Aarav06635/UVC-LED-DRIVER/IISC project certificate .pdf

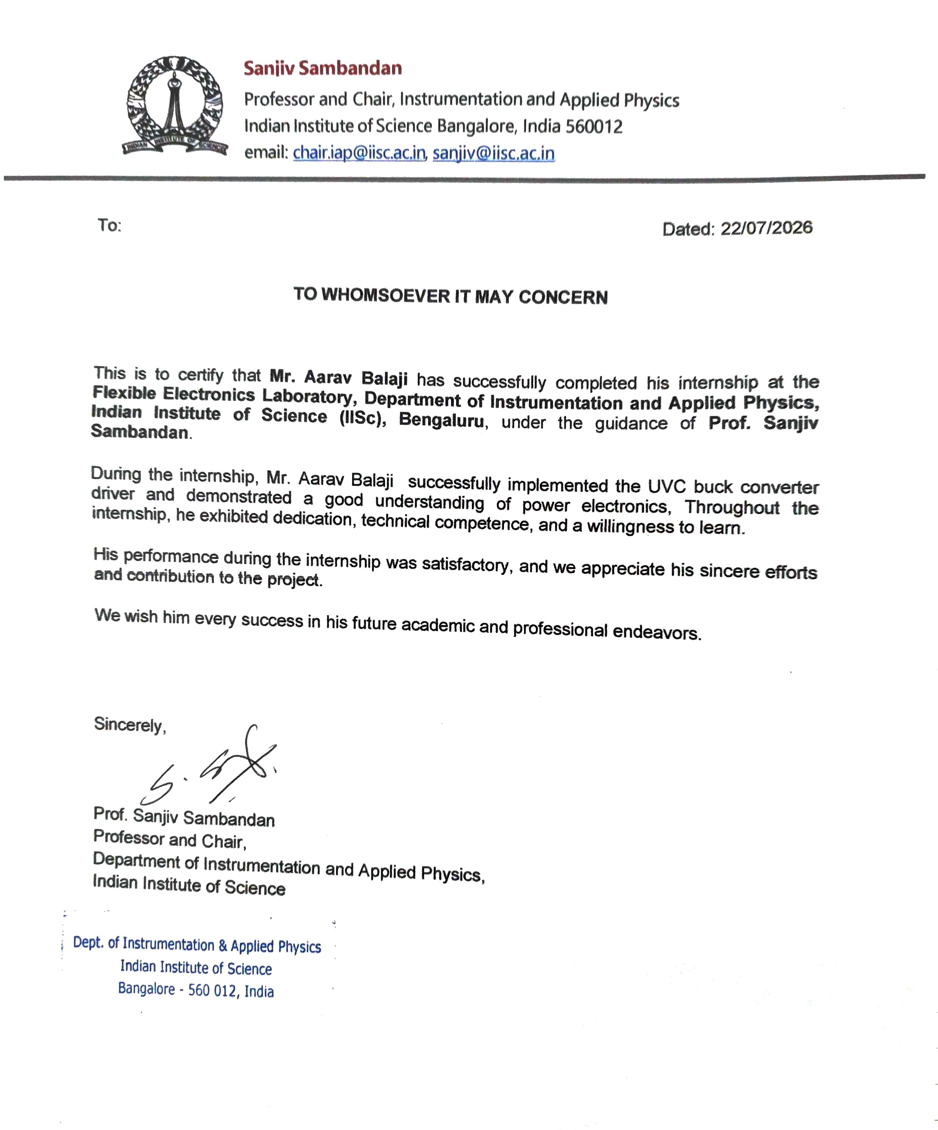
[picture p8: page 1]
