Aarav06635/UVC-LED-DRIVER/LED driver.asc

C1: cap; 1n
C2: cap; 1µ
D1: diode; 1N5818
L1: ind; 1m
M1: nmos; IRFZ44N
R1: res; 100
R2: res; 10k
R3: res; 30
V1: voltage; 18
V2: voltage; PULSE(0 25 0 10n 10n 13.3u 20u)
Named nets: 0
.tran 0 5m 0 100n
