Aarav06635/UVC-LED-DRIVER/LED driver_2.asc

C1: cap; 220n
C2: cap; 1µ
D1: diode; 1N5818
D2: diode; 1N4148
L1: ind; 1m
M1: nmos; IRFZ44N
M2: nmos; IRFZ44N
M3: nmos; IRFZ44N
R1: res; 100
R3: res; 30
V1: voltage; 18
V2: voltage; PULSE(0 25 0 10n 10n 6.7u 20u)
Named nets: 0
.tran 0 20m 0 100n
Bootstrap method
