Aarav06635/UVC-LED-DRIVER/LED driver_3.asc

C1: cap; 220n
C2: cap; 1µ
C3: cap; 30n
D1: diode; 1N5818
D2: diode; 1N4148
D3: diode; 1N4148
L1: ind; 1m
M1: nmos; IRFZ44N
M2: nmos; IRFZ44N
M3: nmos; IRFZ44N
R1: res; 100
R2: res; 12k
R3: res; 30
V1: voltage; 18
V2: voltage; PULSE(0 5 0 10n 10n 6.7u 20u)
Named nets: 0
.tran 0 20m 0 100n
Snubber included
