Aarav06635/UVC-LED-DRIVER/LED driver_5 PROTOTYPE .asc

C1: cap; 200n
C2: cap; 10µ
C3: cap; 300n
D1: diode; 1N5818
D2: diode; 1N4148
D3: diode; 1N4148
L1: ind; 1m
M1: nmos; IRFZ44N
M2: nmos; IRFZ44N
M3: nmos; IRFZ44N
R1: res; 100
R2: res; 1k
R3: res; 7
R4: res; 10K
V1: voltage; 18
V2: voltage; PULSE(0 5 0 10n 10n 11.1u 50u)
Named nets: 0
.tran 0 30m 0 100n
Klaaran
