Aarav06635/UVC-LED-DRIVER/(commit log)

2026-08-14 Add files via upload
    This section has the LT spice files . The files are labelled 1 to 5 and shows the progression and steps i took in making every prototype i used . Refer to the report to guage some of the difficulties and changes that were made
2026-08-14 Add files via upload
    This the zip file of the final gerber files for the PCB that was made
