Aarav06635/UVC-LED-DRIVER/(notices)

Notices in the files:
README.md:
License: MIT
